javighawk/BXDrone/hw_design/bxdrone_board_bottom.pdf

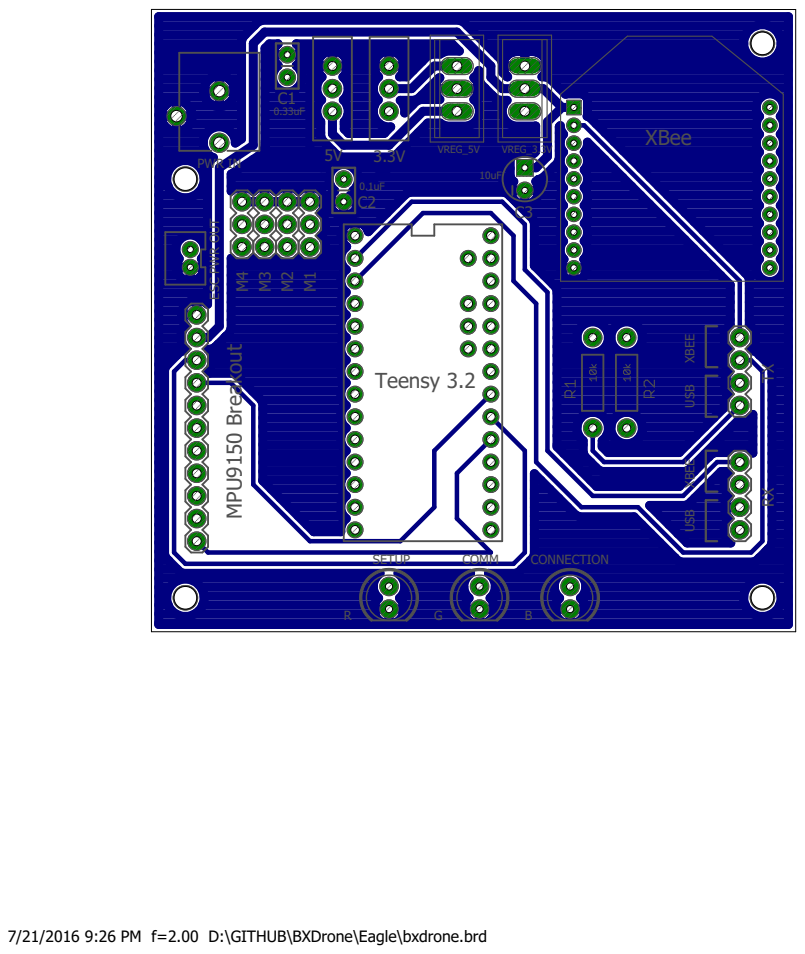
[picture p1: page 1]

XBEE USB

7/21/2016 9:26 PM f=2.00 D:\GITHUB\BXDrone\Eagle\bxdrone.brd
