javighawk/BXDrone/hw_design/bxdrone_schematic.pdf

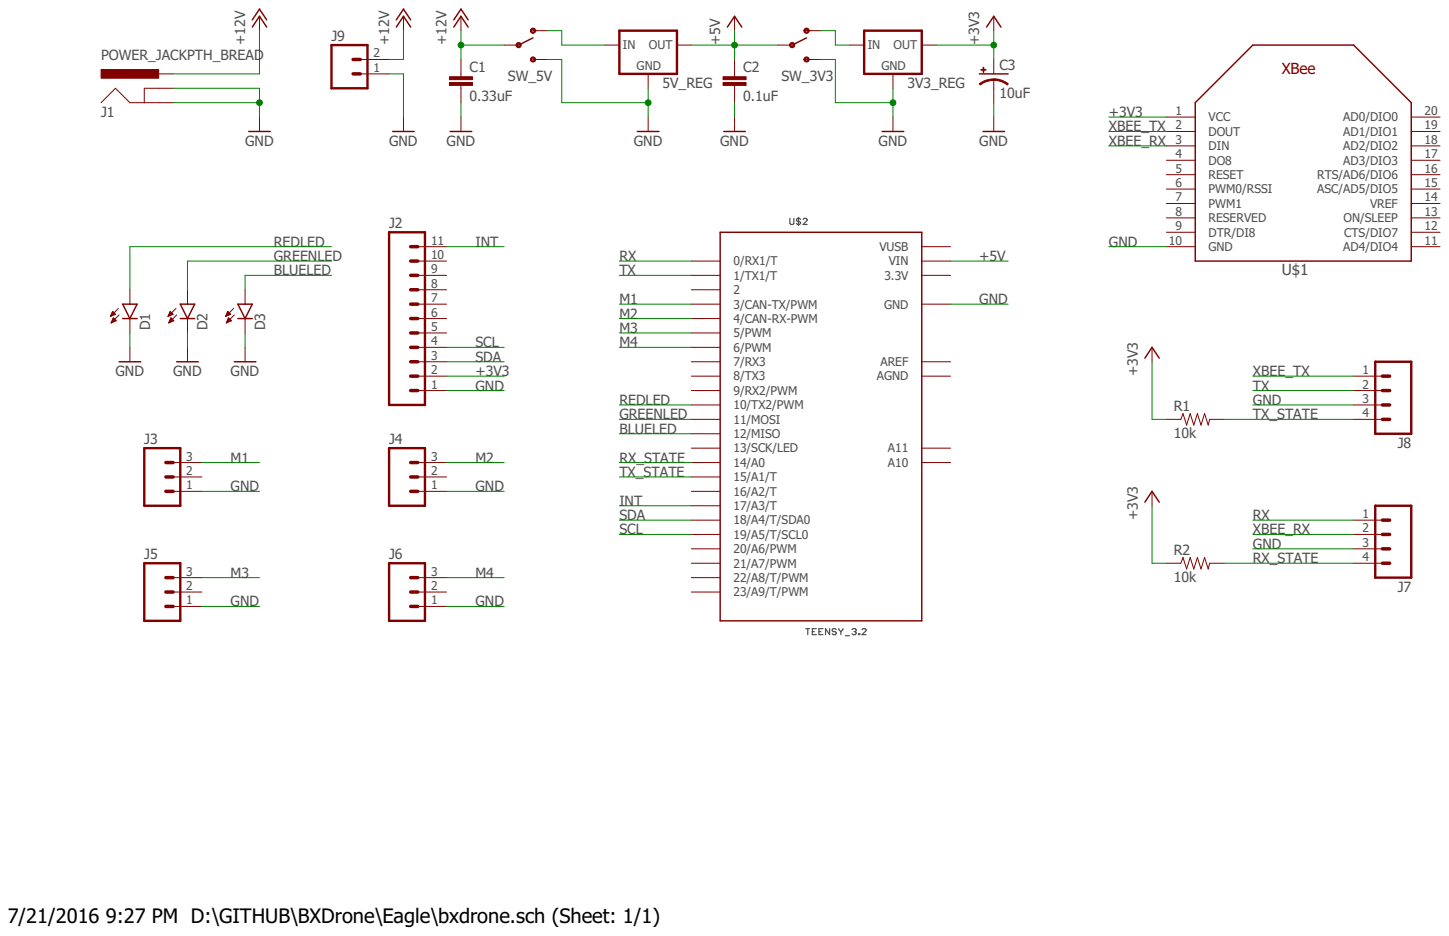
[picture p2: page 1]

7/21/2016 9:27 PM D:\GITHUB\BXDrone\Eagle\bxdrone.sch (Sheet: 1/1)
