javighawk/BXDrone/hw_design/bxdrone.brd

## EAGLE design hw_design/bxdrone.brd (2016-07-22)

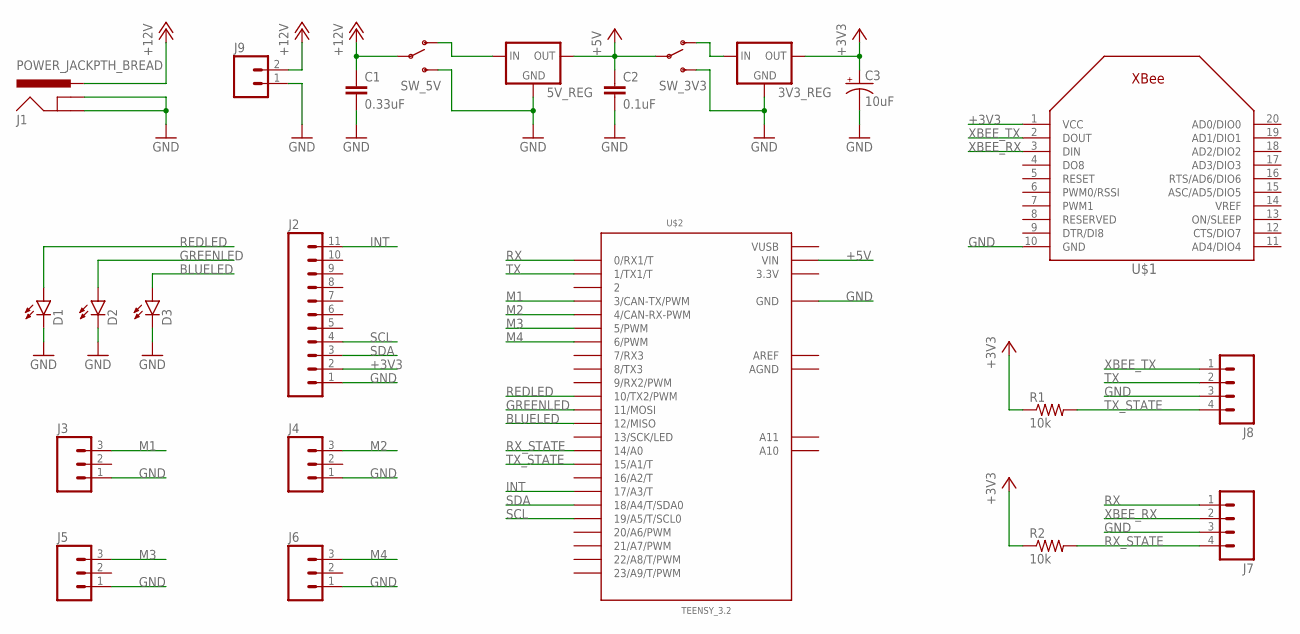
[picture p3: schematic bxdrone.sch]

Parts:
3V3_REG: LD1117V33; TO-220-STANDING
5V_REG: L78S05CV; TO-220-STANDING
C1: 0.33uF; CAP-PTH-SMALL
C2: 0.1uF; CAP-PTH-SMALL
C3: 10uF; CPOL-RADIAL-10UF-25V
D1, D2, D3: LED5MM
J1: POWER_JACKPTH_BREAD; POWER_JACK_PTH_BREAD
J2: M11PTH; 1X11
J3, J4, J5, J6: M03PTH; 1X03
J7, J8: M04PTH; 1X04
J9: M02JST-PTH-VERT; JST-2-PTH-VERT
R1, R2: 10k; AXIAL-0.4
SW_3V3, SW_5V: SWITCH-SPDTPTH; SWITCH-SPDT
U$1: XBEE
U$2: TEENSY_3.2; TEENSY3-DIL+4

Connections:
3.3V: U$2.3.3V
+3V3: 3V3_REG.2 (OUT), C3.1 (+), J2.2, R1.P$1 (1), R2.P$1 (1), U$1.1 (VCC)
+5V: 5V_REG.3 (OUT), C2.1, SW_3V3.2, U$2.VIN
+12V: C1.1, J1.PWR, J9.2, SW_5V.2
AGND: U$2.AGND
AREF: U$2.AREF
BLUELED: D3.A, U$2.12 (12/MISO)
GND: 3V3_REG.1 (GND), 5V_REG.2 (GND), C1.2, C2.2, C3.2 (-), D1.K (C), D2.K (C), D3.K (C), J1.GND, J1.GNDBREAK, J2.1, J3.1, J4.1, J5.1, J6.1, J7.3, J8.3, J9.1, SW_3V3.3 (S), SW_5V.3 (S), U$1.10 (GND), U$2.GND
GREENLED: D2.A, U$2.11 (11/MOSI)
INT: J2.11, U$2.17/A3 (17/A3/T)
M1: J3.3, U$2.3 (3/CAN-TX/PWM)
M2: J4.3, U$2.4 (4/CAN-RX-PWM)
M3: J5.3, U$2.5 (5/PWM)
M4: J6.3, U$2.6 (6/PWM)
unnamed: 5V_REG.1 (IN), SW_5V.1 (O)
unnamed: 3V3_REG.3 (IN), SW_3V3.1 (O)
REDLED: D1.A, U$2.10 (10/TX2/PWM)
RX: J7.1, U$2.0 (0/RX1/T)
RX_STATE: J7.4, R2.P$2 (2), U$2.14/A0
SCL: J2.4, U$2.19/A5 (19/A5/T/SCL0)
SDA: J2.3, U$2.18/A4 (18/A4/T/SDA0)
TX: J8.2, U$2.1 (1/TX1/T)
TX_STATE: J8.4, R1.P$2 (2), U$2.15/A1 (15/A1/T)
VUSB: U$2.VUSB
XBEE_RX: J7.2, U$1.3 (DIN)
XBEE_TX: J8.1, U$1.2 (DOUT)

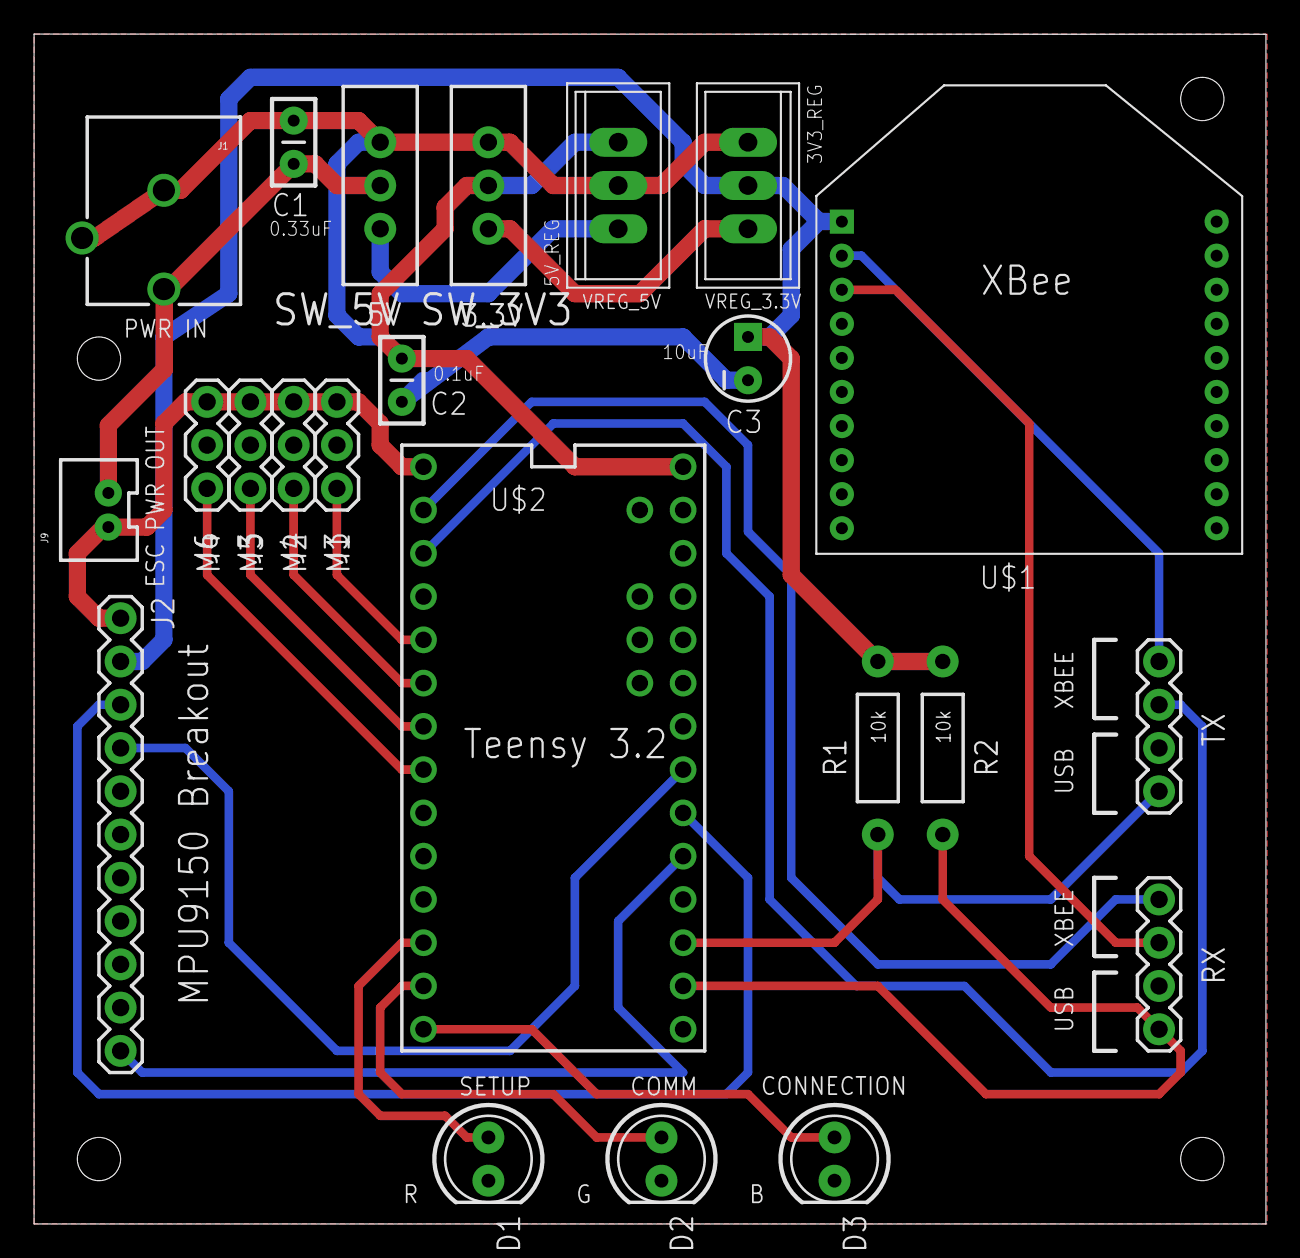
[picture p4: board bxdrone.brd from above]

Board: 2 copper layers, 72.3 x 69.9 mm, 23 parts (0 on the bottom side), 22 nets.
