javighawk/BXDrone/src/BXD_Controller/IMUManager.h

#ifndef IMUManager_h
#define IMUManager_h


/*****************************************/
/**************** INCLUDES ***************/
/*****************************************/

#include "BXD.h"


/*****************************************/
/**************** DEFINES ****************/
/*****************************************/


/*****************************************/
/**************** VARIABLES **************/
/*****************************************/


/*******************************************/
/**************** FUNCTIONS ****************/
/*******************************************/

void IMU_init();
void IMU_compute();
float IMU_getYaw();
float IMU_getPitch();
float IMU_getRoll();
int16_t IMU_getGyroX();
int16_t IMU_getGyroY();
int16_t IMU_getGyroZ();

#endif
