javighawk/BXDrone/(commit log)

2015-01-29 Moved folder
    Arduino programs needs to be inside a folder with the same name as the
    ".ino" file.
2015-01-30 IMU Managing files
    I have created the files that contain the functions in order to get the
    readings from the IMU, perform any modifications on the device and
    compute the angles.
2015-01-31 IMU fuctions added
    This is the first compiling version for Arduino in which the functions
    of the IMU are added. At the moment only the accelerometer and gyro
    reaedings are used, so the other functionalities are still not
    implemented, so this is still under construction. At this moment it
    compiles but it hasn't been tested on the board yet.
    Issues for Intel Galileo board:
    - Variables called "time", such as the ones used in "Telemetry.cpp" had
    to be changed to another name since it seems to be in conflict with
    something else, still didn't figure out with what.
    - Trying to write directly a "0" into the serial port is getting an
    error message. Lines in "Telemetry.cpp" such as "Serial.write(0)"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
    [BXCommandMode.cpp, BXDrone_v6.ino, IMUManager.cpp, IMUManager.h, PIDManager.cpp, PIDManager.h, Telemetry.cpp]
2015-03-19 IMU functions finished
    All the code has been adapted to the new IMU
2015-06-10 Monitoring processing time
    - Modified the Move mode code in Arduino. The space bar now sends a
    Short Command (instead of a Move mode byte) to stop all the motors.
    - Added the calculation of the time (last, maximum and average) between
    two calls to the function IMU.getMotion6 to know the average sampling
    time for accelerometer and gyroscope data. Aimed to be less than 1ms,
    which is the sampling time for the Accelerometer in the IMU. Also added
    these times to the telemetry and are being displayed on the terminal
    window in Eclipse on the computer side.
    - Arranged the code in BXCommandMode.cpp
    [BXCommandMode.cpp, BXCommandMode.h, BXD.h, BXMoveMode.cpp, IMUManager.cpp, IMUManager.h, Telemetry.cpp]
2015-06-13 Minor changes
    Minor changes on the function names on the BXCommandMode.cpp file and on
    the "delta" times calculation on IMUManager.cpp file
2015-06-13 Fixed minor details on GUI
    Some buttons were activated when the Serial port was not connected yet,
    or they remained deactivated when the port was already open. Fixed now.
2015-06-15 Angles calculation & PID modifications
    - Angles are calculated on Arduino using only accelerometer data.
    - We have now 2 PIDs controlling the angles (pitch and roll) and other
    two reacting against gyroscope (from X and Y axis) readings. The
    gyroscope readings will be used to stabilize the quadcopter while the
    other two PIDs will try to achieve a desired angle.
    - Now the parameter "maxdelta" will record the maximum delta value from
    the last time the Telemetry was sent.
    - All LPF functions have been erased.
    - On PID library, the parameter SampleTime has been changed to double
    [BXD.h, BXDrone_v6.ino, BXMoveMode.cpp, BXMoveMode.h, IMUManager.cpp, PIDManager.cpp]
2015-06-18 Fastest version of the program
    -Fastest code achieved. It still has around 1.2 ms of average time
    between accel/gyro sample requests, that means that we would be losing 1
    out of 6 samples. We will see if this is fast enough or whether we need
    to improve it.
2015-06-19 Calculating angles on the Computer side
    Removed pitch and roll angles telemetry since they are not being
    calculated on the drone, but on the computer. The drone receives the
    desired pitch and roll angles and calculates the accelerometer values
    needed in order to get the desired pitch and roll values.
2015-07-09 Added "set maximum speed" function
    Added the possibility of setting all motors to maximum speed by hitting
    the back space. This is implemented for ESC calibration purposes only.
2015-08-29 Added precision on PID values
    The precision on the PID values has been aumented to 4 decimals
2015-09-29 Added libraries
    Added libraries to the Arduino folder. To use them, Go to Sketch ->
    Import library -> Add library and select all the libraries included
    here.
    Removed unused functions on the Arduino program
2016-07-22 Brand new code. Version 0.1
    [bxdrone.brd, bxdrone.sch]
2016-07-22 Reorganized folders
    [bxdrone.brd, bxdrone.sch]
2016-07-25 Adapted PID output limits
2016-07-25 Changed PID Kv's scaling and Gyro values display limits
2016-07-25 Added time records for main loop and IMU interruption
2016-07-25 Added TimeRecord class
2016-07-25 Added telemetry for TimeRecord objects
2016-07-31 Added TimeRecord object to measure telemetry time
